freedragon/lumix-g6-lens-release-button/lumix_g6_button_prototype.step

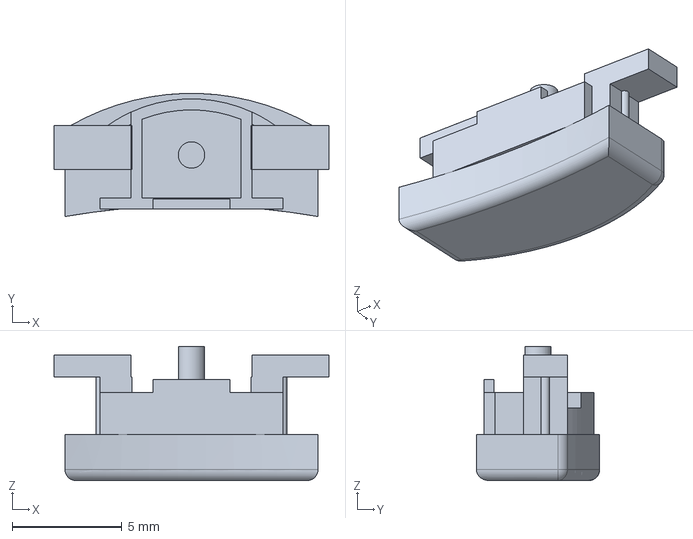
[picture p1: CAD file, 2026-10-22]
lumix_g6_button_prototype.step
12.5 x 5.60 x 6.10 mm
