freedragon/lumix-g6-lens-release-button/(list of files, cad)

Other CAD files:
lumix_g6_button_prototype.FCStd
lumix_g6_button_prototype.stl
